RodNewHampshire/MRF101-150W-HF-Broadband-Amplifier/MRF101 AMP Sensor & Control Board_v2.jpg

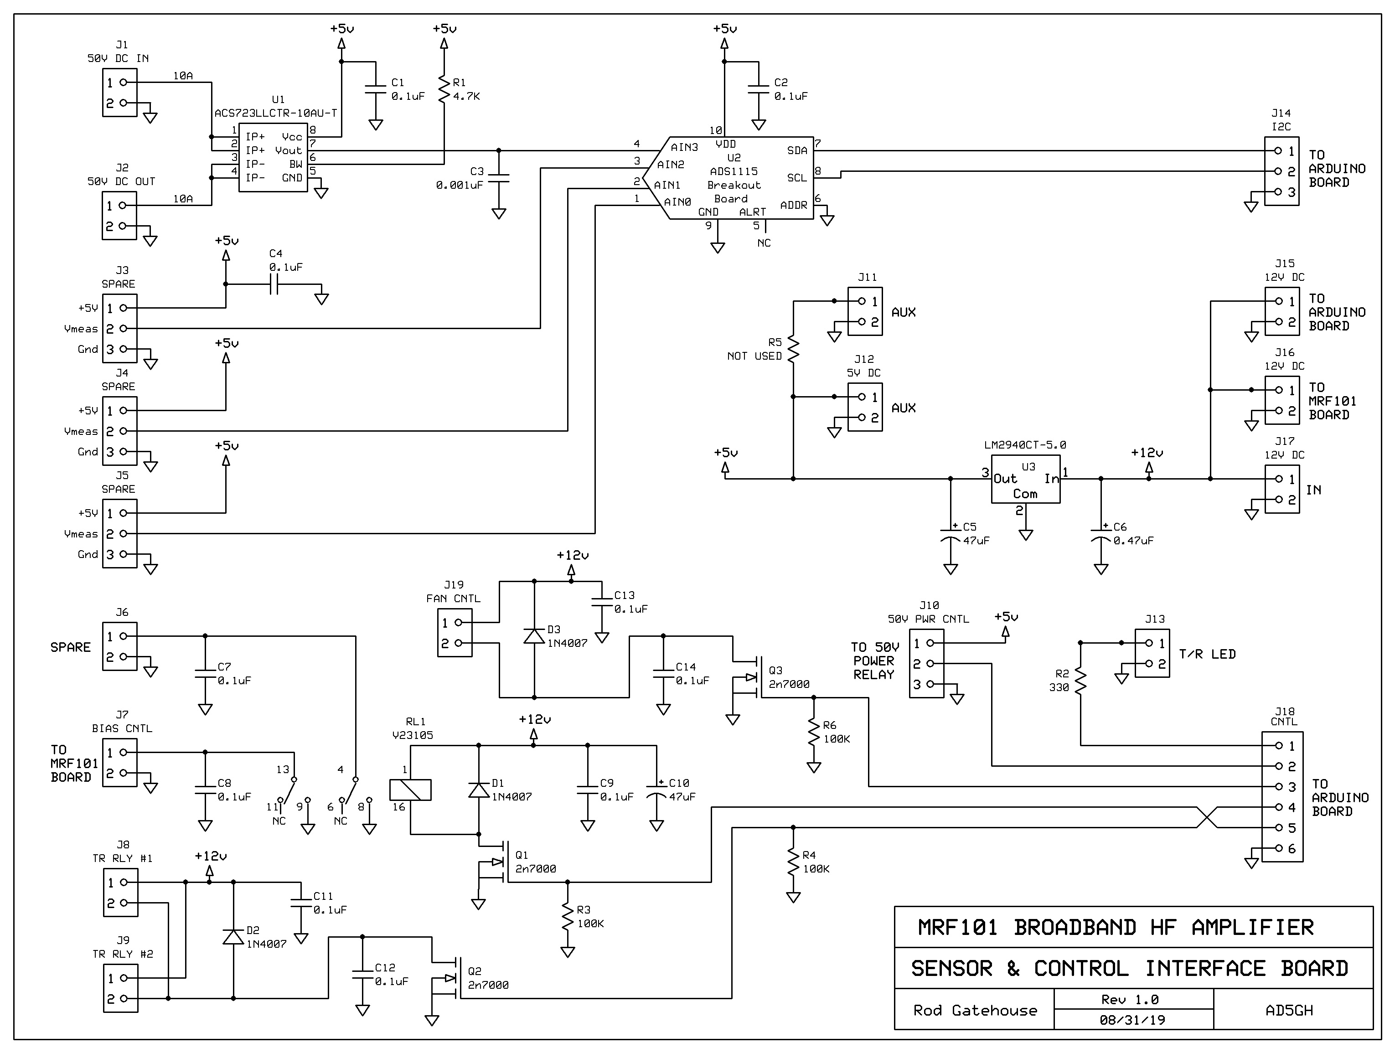
MRF101 AMP Sensor & Control Board_v2.jpg
