RodNewHampshire/MRF101-150W-HF-Broadband-Amplifier/MRF101 200W HF Amp_v2.pdf

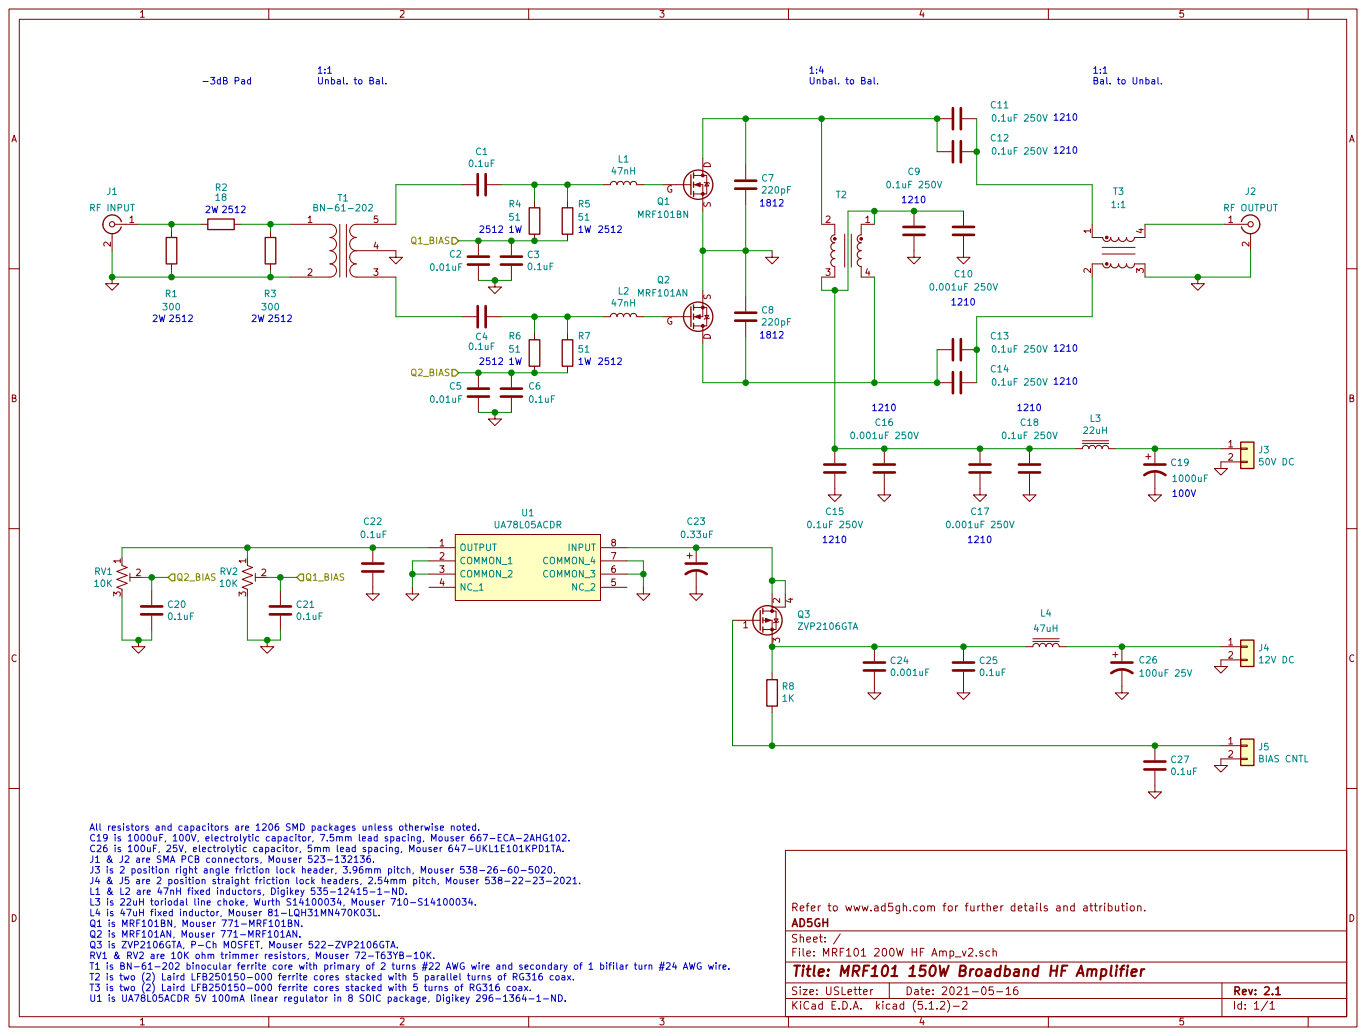
[picture p2: page 1]

All resistors and capacitors are 1206 SMD packages unless otherwise noted.
C19 is 1000uF, 100V, electrolytic capacitor, 7.5mm lead spacing, Mouser 667-ECA-2AHG102.
C26 is 100uF, 25V, electrolytic capacitor, 5mm lead spacing, Mouser 647-UKL1E101KPD1TA. J1 & J2 are SMA PCB connectors, Mouser 523-132136. J3 is 2 position right angle friction lock header, 3.96mm pitch, Mouser 538-26-60-5020.

J4 & J5 are 2 position straight friction lock headers, 2.54mm pitch, Mouser 538-22-23-2021.
L1 & L2 are 47nH fixed inductors, Digikey 535-12415-1-ND. L3 is 22uH toriodal line choke, Wurth S14100034, Mouser 710-S14100034. L4 is 47uH fixed inductor, Mouser 81-LQH31MN470K03L. Q1 is MRF101BN, Mouser 771-MRF101BN. Q2 is MRF101AN, Mouser 771-MRF101AN. Q3 is ZVP2106GTA, P-Ch MOSFET, Mouser 522-ZVP2106GTA. RV1 & RV2 are 10K ohm trimmer resistors, Mouser 72-T63YB-10K. T1 is BN-61-202 binocular ferrite core with primary of 2 turns #22 AWG wire and secondary of 1 bifilar turn #24 AWG wire.

Refer to www.ad5gh.com for further details and attribution.
File: MRF101 200W HF Amp_v2.sch Sheet: / AD5GH

T2 is two (2) Laird LFB250150-000 ferrite cores stacked with 5 parallel turns of RG316 coax.
T3 is two (2) Laird LFB250150-000 ferrite cores stacked with 5 turns of RG316 coax.
U1 is UA78L05ACDR 5V 100mA linear regulator in 8 SOIC package, Digikey 296-1364-1-ND.

Id: 1/1 Title: MRF101 150W Broadband HF Amplifier
