RodNewHampshire/MRF101-150W-HF-Broadband-Amplifier/(list of files, drawings)

Other design files:
Sensor & Control Board_v2.pcb
